cerberuspower/monochromator/Přílohy/SCHÉMA+ SEZNAM součástek/monochromator.pdf

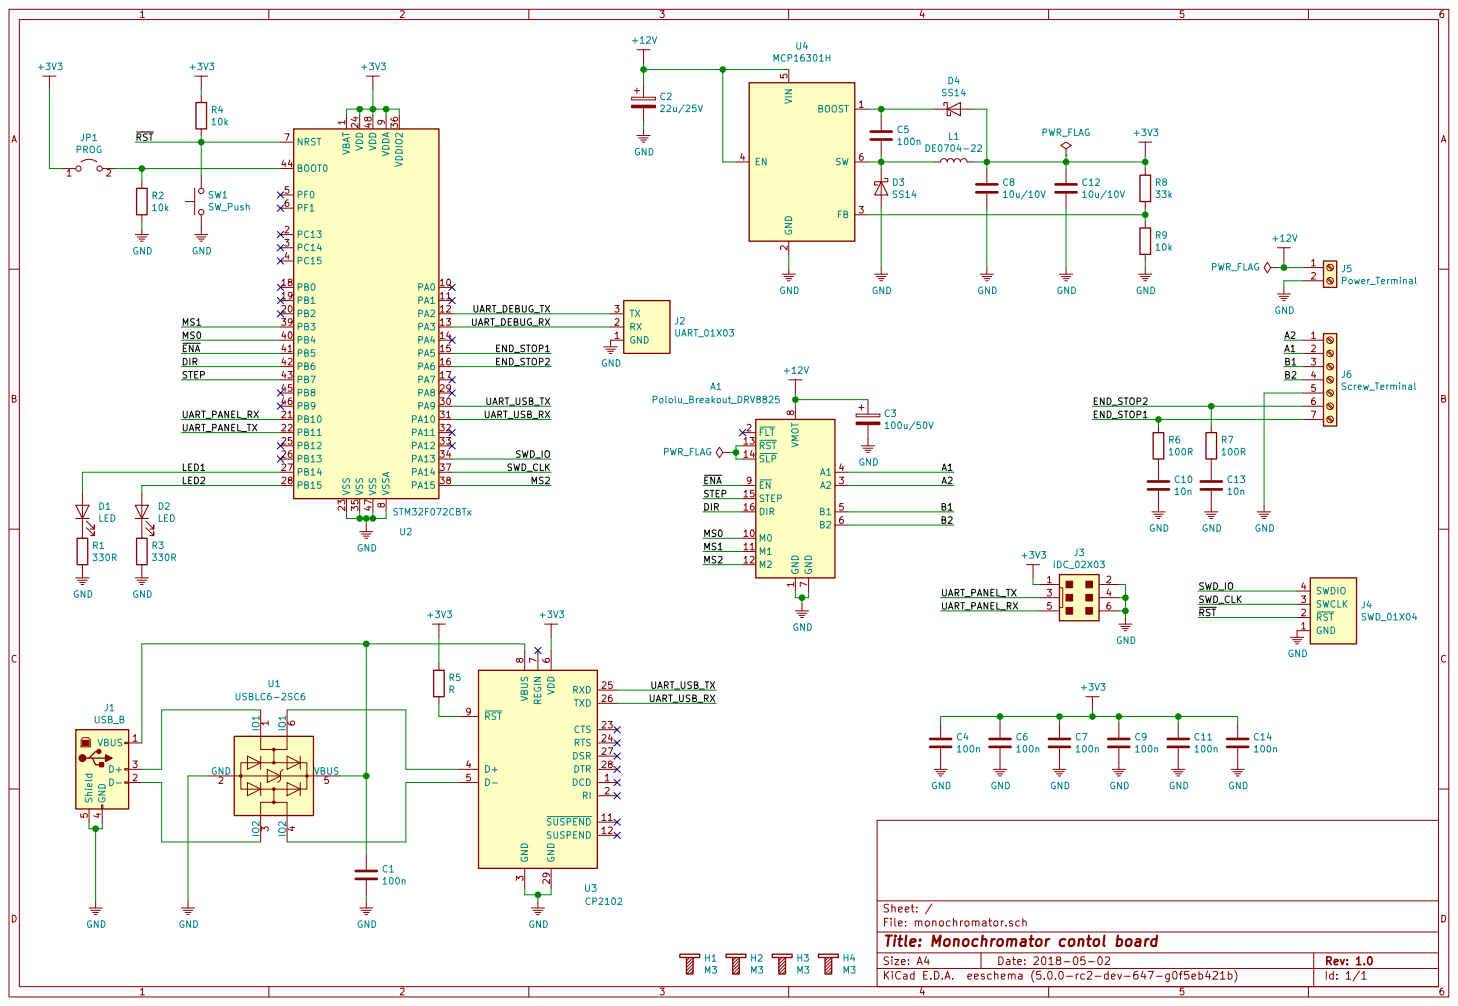
[picture p1: page 1]

9 VDDIO2 36 VSS 23 VSS 35 VSS 47 VSSA

1 M0 10 M1 11 M2 12 RST 13 SLP 14 STEP 15 DIR 16 FLT 2 A2 3 A1 4 B1 5 B2 6 GND

File: monochromator.sch Sheet: /
Id: 1/1 Title: Monochromator contol board
