cerberuspower/monochromator/Přílohy/HW KiCad Project/monochromator.kicad_pcb

## KiCad design Přílohy/HW KiCad Project/monochromator.kicad_pcb (2018-05-15)

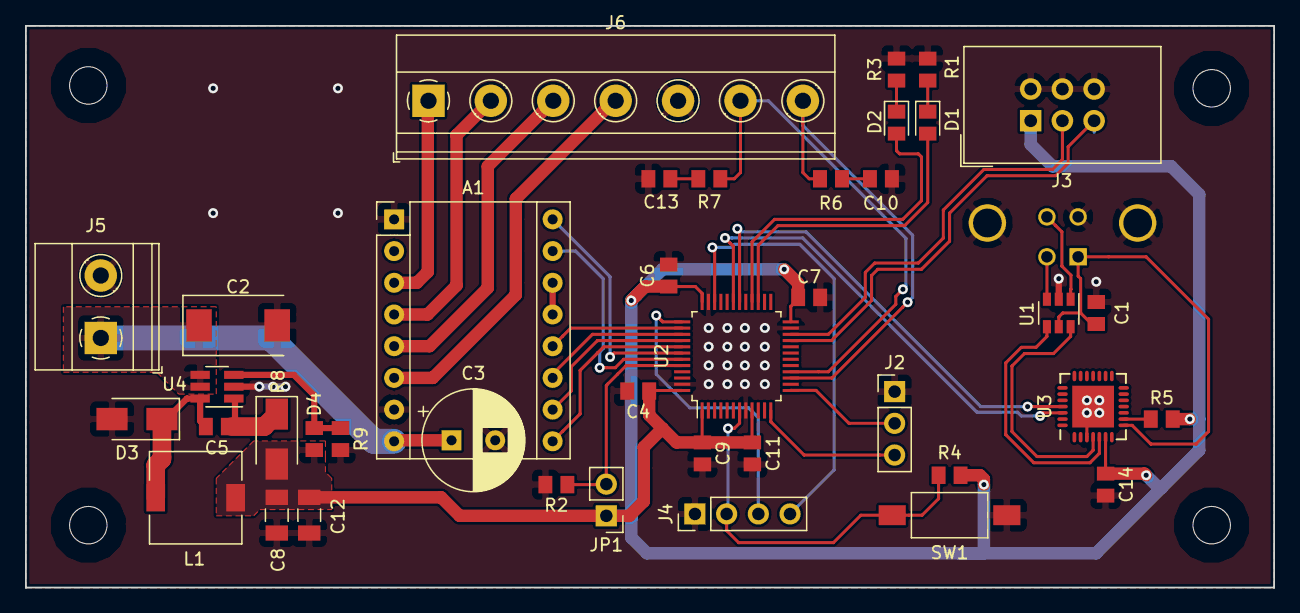
[picture p2: board monochromator.kicad_pcb from above]

Board: 2 copper layers, 100.0 x 45.0 mm, 45 parts (1 on the bottom side), 41 nets.

Parts:
A1: Pololu_Breakout_DRV8825; Pololu_Breakout-16_15.2x20.3mm
C1, C4, C5, C6, C7, C9, C11, C14: 100n; C_0805_2012Metric
C2: 22u/25V; CP_EIA-7343-31_Kemet-D
C3: 100u/50V; CP_Radial_D8.0mm_P3.50mm
C8, C12: 10u/10V; C_1206_3216Metric
C10, C13: 10n; C_0805_2012Metric
D1, D2: LED; LED_0805_2012Metric
D3, D4: SS14; D_SMA
H1, H2, H3, H4: M3; Bolt_M3
J1: USB_B; USB_B_TE_5787834_Vertical
J2: UART_01X03; PinHeader_1x03_P2.54mm_Vertical
J3: IDC_02X03; IDC-Header_2x03_P2.54mm_Vertical
J4: SWD_01X04; PinHeader_1x04_P2.54mm_Vertical
J5: Power_Terminal; TerminalBlock_Phoenix_MKDS-1,5-2_1x02_P5.00mm_Horizontal
J6: Screw_Terminal; TerminalBlock_Phoenix_MKDS-1,5-7_1x07_P5.00mm_Horizontal
JP1: PROG; PinHeader_1x02_P2.54mm_Vertical
L1: DE0704-22; L_7.3x7.3_H4.5
R1, R3: 330R; R_0805_2012Metric
R2, R4, R9: 10k; R_0805_2012Metric
R5: R; R_0805_2012Metric
R6, R7: 100R; R_0805_2012Metric
R8: 33k; R_0805_2012Metric
SW1: SW_Push; SW_SPST_FSMSM
U1: USBLC6-2SC6; SOT-23-6
U2: STM32F072CBTx; LQFP-48_7x7mm_P0.5mm
U3: CP2102; QFN-28-1EP_5x5mm_P0.5mm_EP3.35x3.35mm
U4: MCP16301H; SOT-23-6_Handsoldering

Connections:
+3V3: C4.1, C6.1, C7.1, C8.1, C9.1, C11.1, C12.1, C14.1, D4.2, J3.1, JP1.1, L1.2, R4.1, R5.1, R8.1, U2.1, U2.9, U2.24, U2.36, U2.48, U3.6
+12V: A1.8, C2.1, C3.1, J5.1, U4.4, U4.5
/A1: A1.4, J6.2
/A2: A1.3, J6.1
/B1: A1.5, J6.3
/B2: A1.6, J6.4
/DIR: A1.16, U2.42
/END_STOP1: J6.7, R6.1, U2.15
/END_STOP2: J6.6, R7.1, U2.16
/LED1: D1.2, U2.27
/LED2: D2.2, U2.28
/MS0: A1.10, U2.40
/MS1: A1.11, U2.39
/MS2: A1.12, U2.38
/STEP: A1.15, U2.43
/SWD_CLK: J4.3, U2.37
/SWD_IO: J4.4, U2.34
/UART_DEBUG_RX: J2.2, U2.13
/UART_DEBUG_TX: J2.3, U2.12
/UART_PANEL_RX: J3.5, U2.21
/UART_PANEL_TX: J3.3, U2.22
/UART_USB_RX: U2.31, U3.26
/UART_USB_TX: U2.30, U3.25
/~ENA: A1.9, U2.41
/~RST: J4.2, R4.2, SW1.2, U2.7
GND: A1.1, A1.7, C1.2, C2.2, C3.2, C4.2, C6.2, C7.2, C8.2, C9.2, C10.2, C11.2, C12.2, C13.2, C14.2, D3.2, J1.4, J1.5, J2.1, J3.2, J3.4, J3.6, J4.1, J5.2, J6.5, R1.2, R2.2, R3.2, R9.2, SW1.1, U1.2, U2.8, U2.23, U2.35, U2.47, U3.3, U3.29, U4.2
unnamed: A1.13, A1.14
unnamed: C1.1, J1.1, U1.5, U3.8
unnamed: C5.1, D4.1, U4.1
unnamed: C5.2, D3.1, L1.1, U4.6
unnamed: C10.1, R6.2
unnamed: C13.1, R7.2
unnamed: D1.1, R1.1
unnamed: D2.1, R3.1
unnamed: J1.2, U1.3
unnamed: J1.3, U1.1
unnamed: JP1.2, R2.1, U2.44
unnamed: R5.2, U3.9
unnamed: R8.2, R9.1, U4.3
unnamed: U1.4, U3.5
unnamed: U1.6, U3.4
