cerberuspower/monochromator/FW_Control_Board/Src/main.c

/**
  ******************************************************************************
  * @file           : main.c
  * @brief          : Main program body
  ******************************************************************************
  ** This notice applies to any and all portions of this file
  * that are not between comment pairs USER CODE BEGIN and
  * USER CODE END. Other portions of this file, whether
  * inserted by the user or by software development tools
  * are owned by their respective copyright owners.
  *
  * COPYRIGHT(c) 2018 STMicroelectronics
  *
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
  ******************************************************************************
  */
/* Includes ------------------------------------------------------------------*/
#include "main.h"
#include "stm32f0xx_hal.h"

/* USER CODE BEGIN Includes */
#include "globals.hpp"
/* USER CODE END Includes */

UART_HandleTypeDef huart1;
UART_HandleTypeDef huart2;
UART_HandleTypeDef huart3;

/* USER CODE BEGIN PV */

/* USER CODE END PV */

void SystemClock_Config(void);
static void MX_GPIO_Init(void);
static void MX_USART1_UART_Init(void);
static void MX_USART2_UART_Init(void);
static void MX_USART3_UART_Init(void);

/* USER CODE BEGIN PFP */

/* USER CODE END PFP */

/**
  * @brief  The application entry point.
  *
  * @retval None
  */
int main(void)
{
  /* MCU Configuration----------------------------------------------------------*/

  /* Reset of all peripherals, Initializes the Flash interface and the Systick. */
  HAL_Init();

  /* Configure the system clock */
  SystemClock_Config();

  /* Initialize all configured peripherals */
    MX_GPIO_Init();
    MX_USART1_UART_Init();
    MX_USART2_UART_Init();
    MX_USART3_UART_Init();
  /* USER CODE BEGIN 2 */

    uint8_t n_step_divider=32;
    Uart uart(&huart1);
    monochromator.uart = &uart;
    monochromator.uart->receive_it();

    Motor motor(1.8, n_step_divider);
    monochromator.motor = &motor;
    monochromator.end_stop_forward = END_STOP_FORWARD_Pin;
    monochromator.end_stop_reverse = END_STOP_REVERSE_Pin;
    monochromator.Max_Wavelength=3500000;
    monochromator.Min_Wavelength=250000;
    monochromator.step_divider_settings=n_step_divider;
    monochromator.motor->dir(DIRECTION_REVERSE);

    monochromator.uart->print("init ok\n");
  /* USER CODE END 2 */

  /* Infinite loop */
  /* USER CODE BEGIN WHILE */
  while (1)
  {
    if (monochromator.uart->get_rx_flag())
    {
        monochromator.uart->print("Mam data: ");
        monochromator.uart->send_byte(monochromator.uart->rx_buffer[0]);
        monochromator.uart->print("\n");
        buffer_analyze((char*)monochromator.uart->rx_buffer);
        monochromator.uart->clear_rx_flag();
    }
/* USER CODE END WHILE */

  /* USER CODE BEGIN 3 */

  }
  /* USER CODE END 3 */

}

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
