cerberuspower/monochromator/fw_STM32F072/monochromator.ioc

Mcu.UserName=STM32F072CBTx
PA10.Signal=USART1_RX
PA13.Signal=SYS_SWDIO
PA14.Signal=SYS_SWCLK
PA15.GPIO_Label=MS3
PA15.Signal=GPIO_Output
PA2.Signal=USART2_TX
PA3.Signal=USART2_RX
PA5.GPIO_Label=END_STOP1
PA5.Signal=GPXTI5
PA6.GPIO_Label=END_STOP2
PA6.Signal=GPXTI6
PA9.Signal=USART1_TX
PB10.Signal=USART3_TX
PB11.Signal=USART3_RX
PB3.GPIO_Label=MS2
PB3.Signal=GPIO_Output
PB4.GPIO_Label=MS1
PB4.Signal=GPIO_Output
PB5.GPIO_Label=ENA
PB5.Signal=GPIO_Output
PB6.GPIO_Label=DIR
PB6.Signal=GPIO_Output
PB7.GPIO_Label=STEP
PB7.Signal=GPIO_Output
PC14-OSC32_IN.GPIO_Label=LED1
PC14-OSC32_IN.Signal=GPIO_Output
PC15-OSC32_OUT.GPIO_Label=LED2
PC15-OSC32_OUT.Signal=GPIO_Output
