cerberuspower/monochromator/fw_testdesk/Parsing/Parsing.ioc

Mcu.UserName=STM32F303RETx
PA0.GPIO_Label=MS0
PA0.Signal=GPIO_Output
PA1.GPIO_Label=MS1
PA1.Signal=GPIO_Output
PA13.GPIO_Label=TMS
PA13.Signal=SYS_JTMS-SWDIO
PA14.GPIO_Label=TCK
PA14.Signal=SYS_JTCK-SWCLK
PA2.GPIO_Label=USART_TX
PA2.Signal=USART2_TX
PA3.GPIO_Label=USART_RX
PA3.Signal=USART2_RX
PA4.GPIO_Label=MS3
PA4.Signal=GPIO_Output
PA5.GPIO_Label=STEP
PA5.Signal=GPIO_Output
PA6.GPIO_Label=DIR
PA6.Signal=GPIO_Output
PA7.GPIO_Label=ENA
PA7.Signal=GPIO_Output
PB3.GPIO_Label=SWO
PB3.Signal=SYS_JTDO-TRACESWO
PB8.GPIO_Label=END_STOP2
PB8.Signal=GPIO_Input
PB9.GPIO_Label=END_STOP1
PB9.Signal=GPIO_Input
PC13.GPIO_Label=B1 [Blue PushButton]
PC13.Signal=GPXTI13
PC14-OSC32_IN.Signal=RCC_OSC32_IN
PC15-OSC32_OUT.Signal=RCC_OSC32_OUT
PF0-OSC_IN.Signal=RCC_OSC_IN
PF1-OSC_OUT.Signal=RCC_OSC_OUT
