cerberuspower/monochromator/(commit log)

2018-04-27 added STM32Cube template
2018-04-27 added motor.c and motor.h with demo functions
2018-05-02 added cube project for STM32F072
2018-05-02 added wykys first hw prototype
    [monochromator.kicad_pcb, monochromator.sch]
2018-05-02 added boom and updated schematic
    [monochromator.csv]
2018-05-02 add GND plate
    [monochromator.kicad_pcb]
2018-05-03 PCB layout v1.0
    [monochromator.kicad_pcb, monochromator.sch]
2018-05-03 updated power layout
    [monochromator.kicad_pcb]
2018-05-06 desk v2
    [monochromator.kicad_pcb]
2018-05-06 updated footprint placement and updated layout CP1202
    [monochromator.kicad_pcb]
2018-05-06 updated layout and reduced pcb size
    [monochromator.kicad_pcb]
2018-05-06 updated SWD_CLK and via under STM32
    [monochromator.kicad_pcb]
2018-05-15 Python App + GERBERS
    [monochromator-B.Cu.gbr, monochromator-B.Mask.gbr, monochromator-B.SilkS.gbr, monochromator-Edge.Cuts.gbr, monochromator-F.Cu.gbr, monochromator-F.Mask.gbr, monochromator-F.SilkS.gbr, monochromator-NPTH.drl]
2018-05-16 Python objectiication
    [Parsing Run.cfg]
2018-05-22 added motor api
2018-05-22 added uart api
