cerberuspower/monochromator/(notices)

Notices in the files:
FW_Control_Board/Src/main.c:
(C) COPYRIGHT STMicroelectronics *****END OF FILE
